kchan45/APPJ_Control/Software/Post-2020/Documentation/APPJ_Startup-Shudown_Procedure.docx

APPJ Startup/Shutdown Procedure

Mesbah Lab 2021

Last Updated: February 14, 2021

WARNING: The APPJ setup involves high voltage equipment! Use caution during operation, and DO NOT touch/reach into any part of the setup within the PVC cage!!

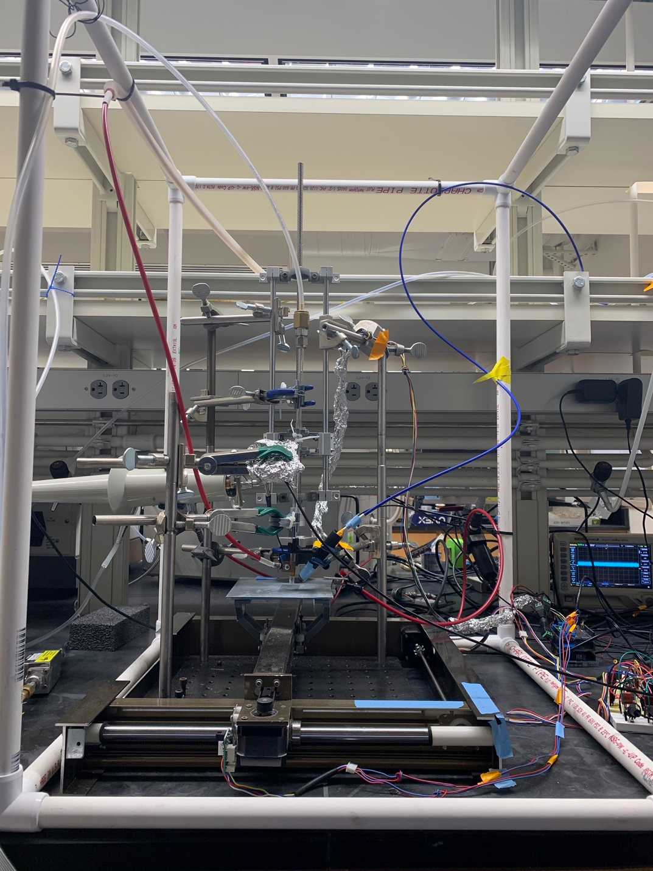
[picture p2: figure]

STARTUP:

1. Open Gas Flow (see Figure 1 for Helium tank setup):
  a. Ensure regulator (large red knob in center) is decreased fully.
  b. Open tank valve on the top of the He gas tank. The gauge on the right should indicate some pressure.
  c. Increase the regulator (turn clockwise) until the left gauge shows an appropriate amount of pressure (enough to get up to 3-5 slm).
  d. Open the line valve on the left (turn parallel to gas line)

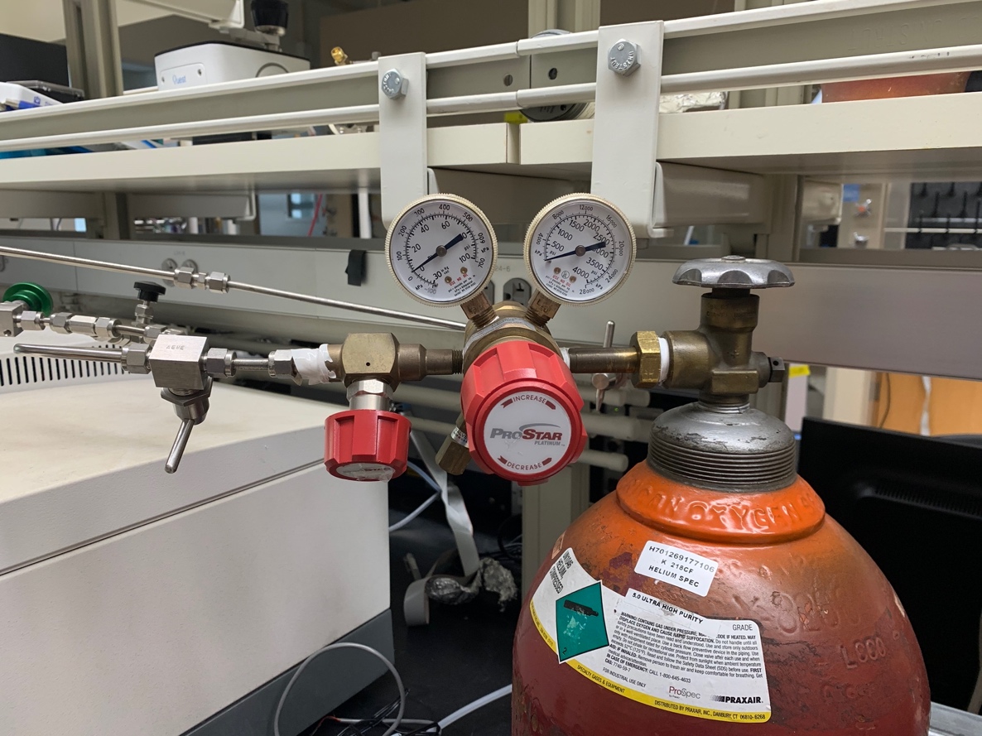
[picture p3: figure]

Line Valve

Regulator

Tank Valve

Figure 1: Helium Tank Setup

2. Turn on Amplifier for Frequency Generator (See Figure 2 for Amplifier startup):
  a. Flip the power switch to turn on power.
  b. Pull gray knob to unlock high voltage lock.
  c. Push white button to turn on high voltage. HV ON indicator light should light up green.

CAUTION: Once this is powered on, do NOT touch anything in the setup!!! Risk of high voltage delivered to body!

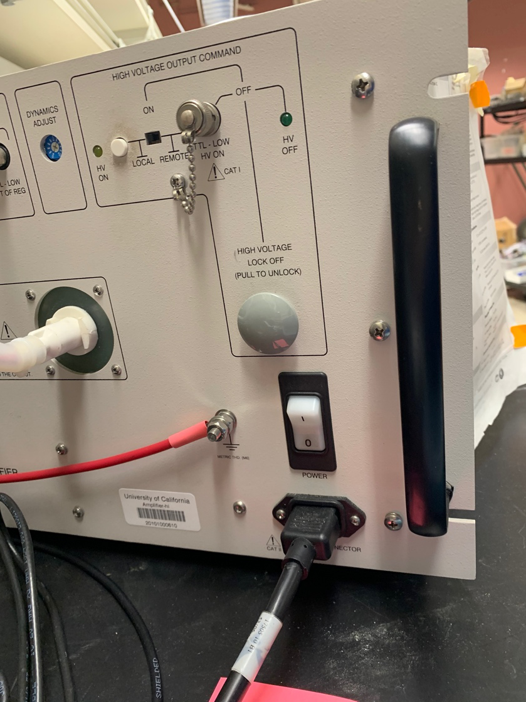
[picture p4: figure]

Figure 2: Amplifier Power Switches

Power Switch

High Voltage Lock

HV Local ON Button

3. Connect Computer to setup:
  a. Locate the USB Hub.
  b. Connect to computer.
4. Startup APPJ by EITHER:
  a. Running Python script: APPJstartup.py provided in APPJ-MacOS-Communication (ensure required dependencies/libraries for Python are installed with pip)
  b. Connecting to the Arduino directly using the following commands in the Terminal:
    i. This line starts/connects the Arduino to the computer and reads the status of the connection: $ stty -f /dev/cu.usbmodem1434401 raw 38400 -hupcl & cat /dev/cu.usbmodem1434401 Ensure the `usbmodem1434401` device number is consistent with what is read by your computer. If you have the Arduino app installed on your computer, this can be checked by going to Tools > Port, and looking at the Arduino device number.
    ii. Then, the following commands can be used to ignite the plasma:
      1. This command sets the duty to 100: $echo "p,100" > /dev/cu.usbmodem1434401
      2. This command sets the power to 2: $echo "w,2" > /dev/cu.usbmodem1434401
      3. This command sets the flow rate to 1.5: $echo "q,1.5" > /dev/cu.usbmodem1434401
    iii. Once started, the same commands can be used to adjust those parameters (duty, power, flow rate). Just change the numerical value in the quotes.

SHUTDOWN:

1. Push the reset button on the Arduino to reset all parameters.
2. Turn off Amplifier (see Figure 2):
  a. Flip the power switch to the off position.
  b. Push the gray knob to lock.
3. Turn off Gas (see Figure 1):
  a. Close tank valve on the top of the tank.
  b. Go to setup. On the manual flow controller (see Figure 3), flip the switch to ‘Purge’ to purge the remaining gas in setup.
  c. Decrease the regulator fully (turn counterclockwise).
  d. Close line valve (turn perpendicular to gas line).

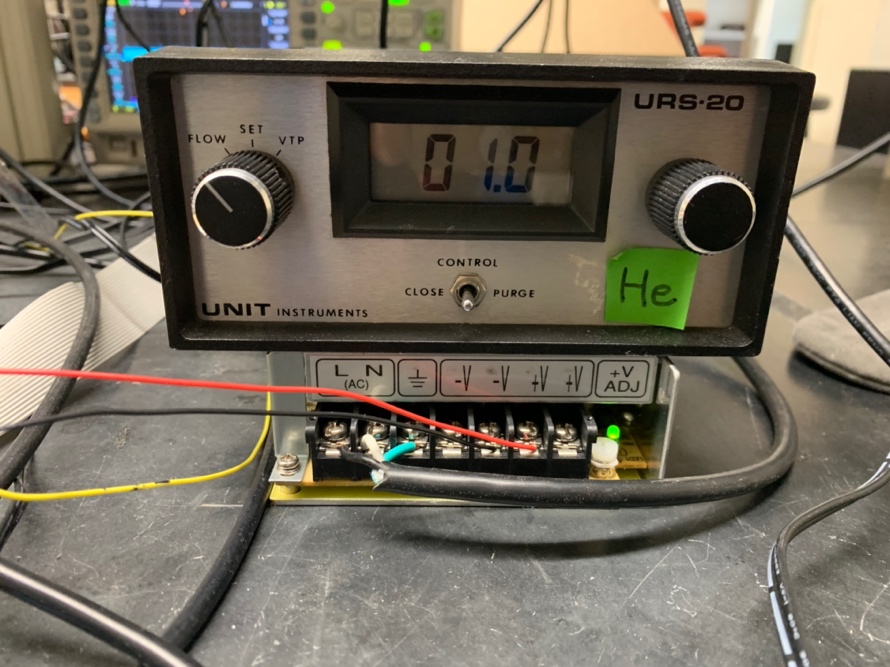
[picture p5: figure]

Figure 3: Manual Flow Controller
