kchan45/APPJ_Control/Software/Post-2020/Firmware/FLiR-lepton/Connections/Connections.png

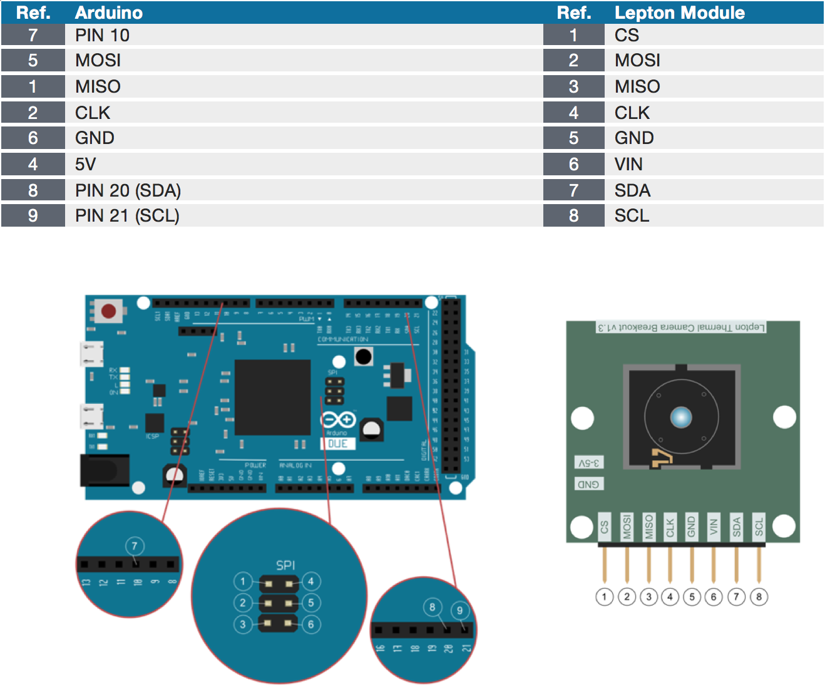
Software/Post-2020/Firmware/FLiR-lepton/Connections/Connections.png
