kchan45/APPJ_Control/Software/Post-2020/Firmware/FLiR-lepton/Connections/Image 2.png

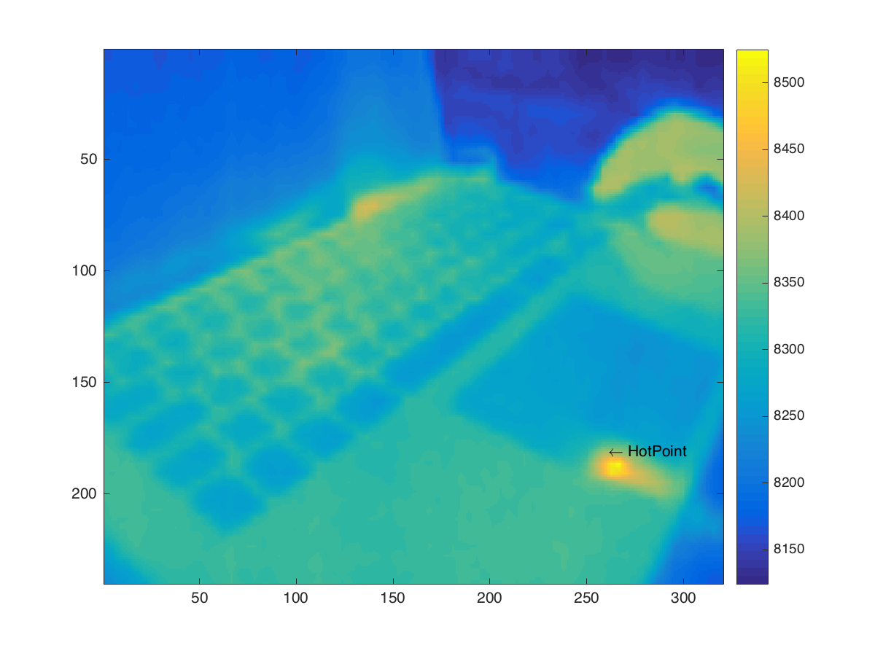
Software/Post-2020/Firmware/FLiR-lepton/Connections/Image 2.png
