kchan45/APPJ_Control/Img/APPJ Setup Pictures/Image_1 2021-03-11_18-36-17.jpeg

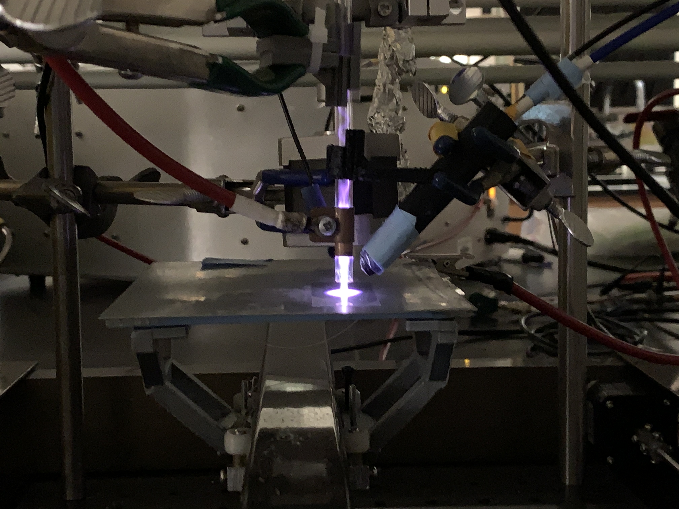
Img/APPJ Setup Pictures/Image_1 2021-03-11_18-36-17.jpeg
