kchan45/APPJ_Control/Img/APPJ Setup Pictures/IMG_1522.jpg

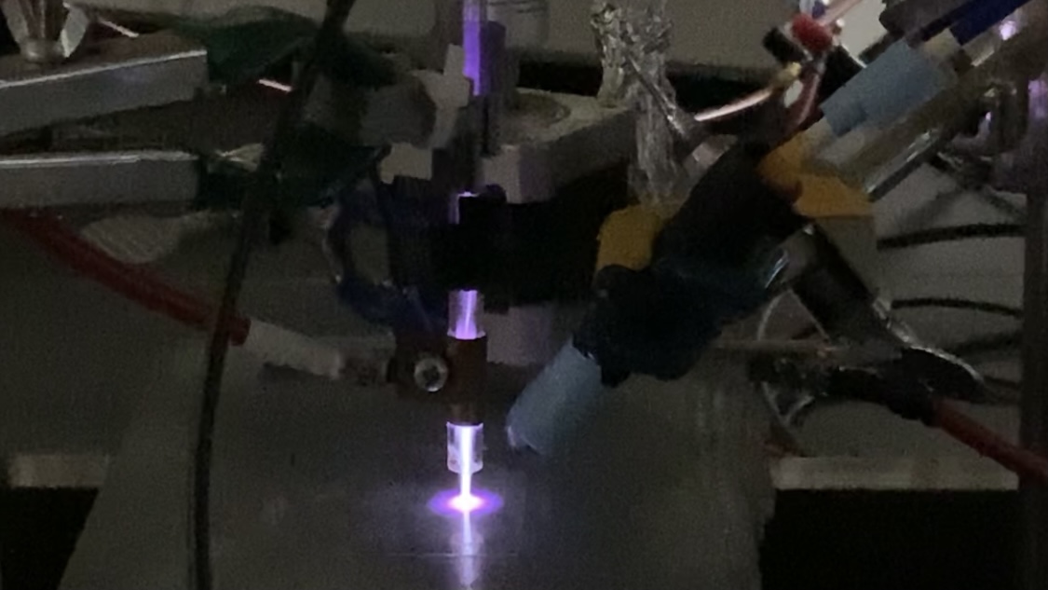
Img/APPJ Setup Pictures/IMG_1522.jpg
