kchan45/APPJ_Control/Img/APPJ Setup Pictures/IMG_1523 2.jpg

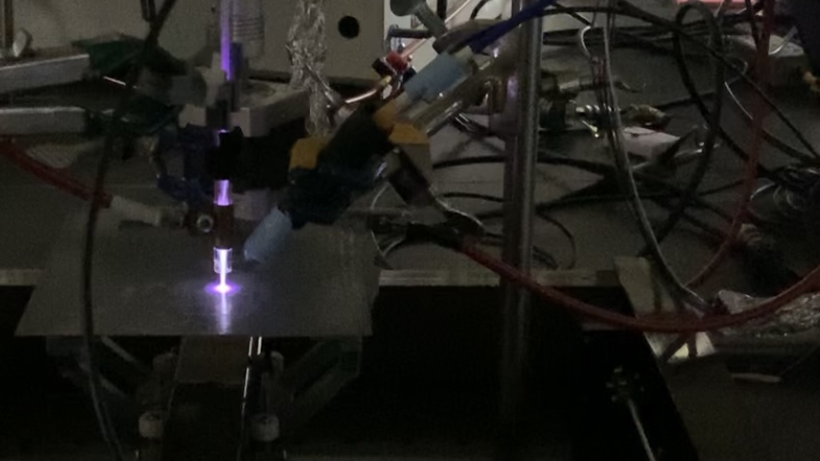
Img/APPJ Setup Pictures/IMG_1523 2.jpg
