kchan45/APPJ_Control/Miscellaneous/Post 2020/Circuits/Schematics/2021-04-16-APPJ-Schematic-Diagram.pdf

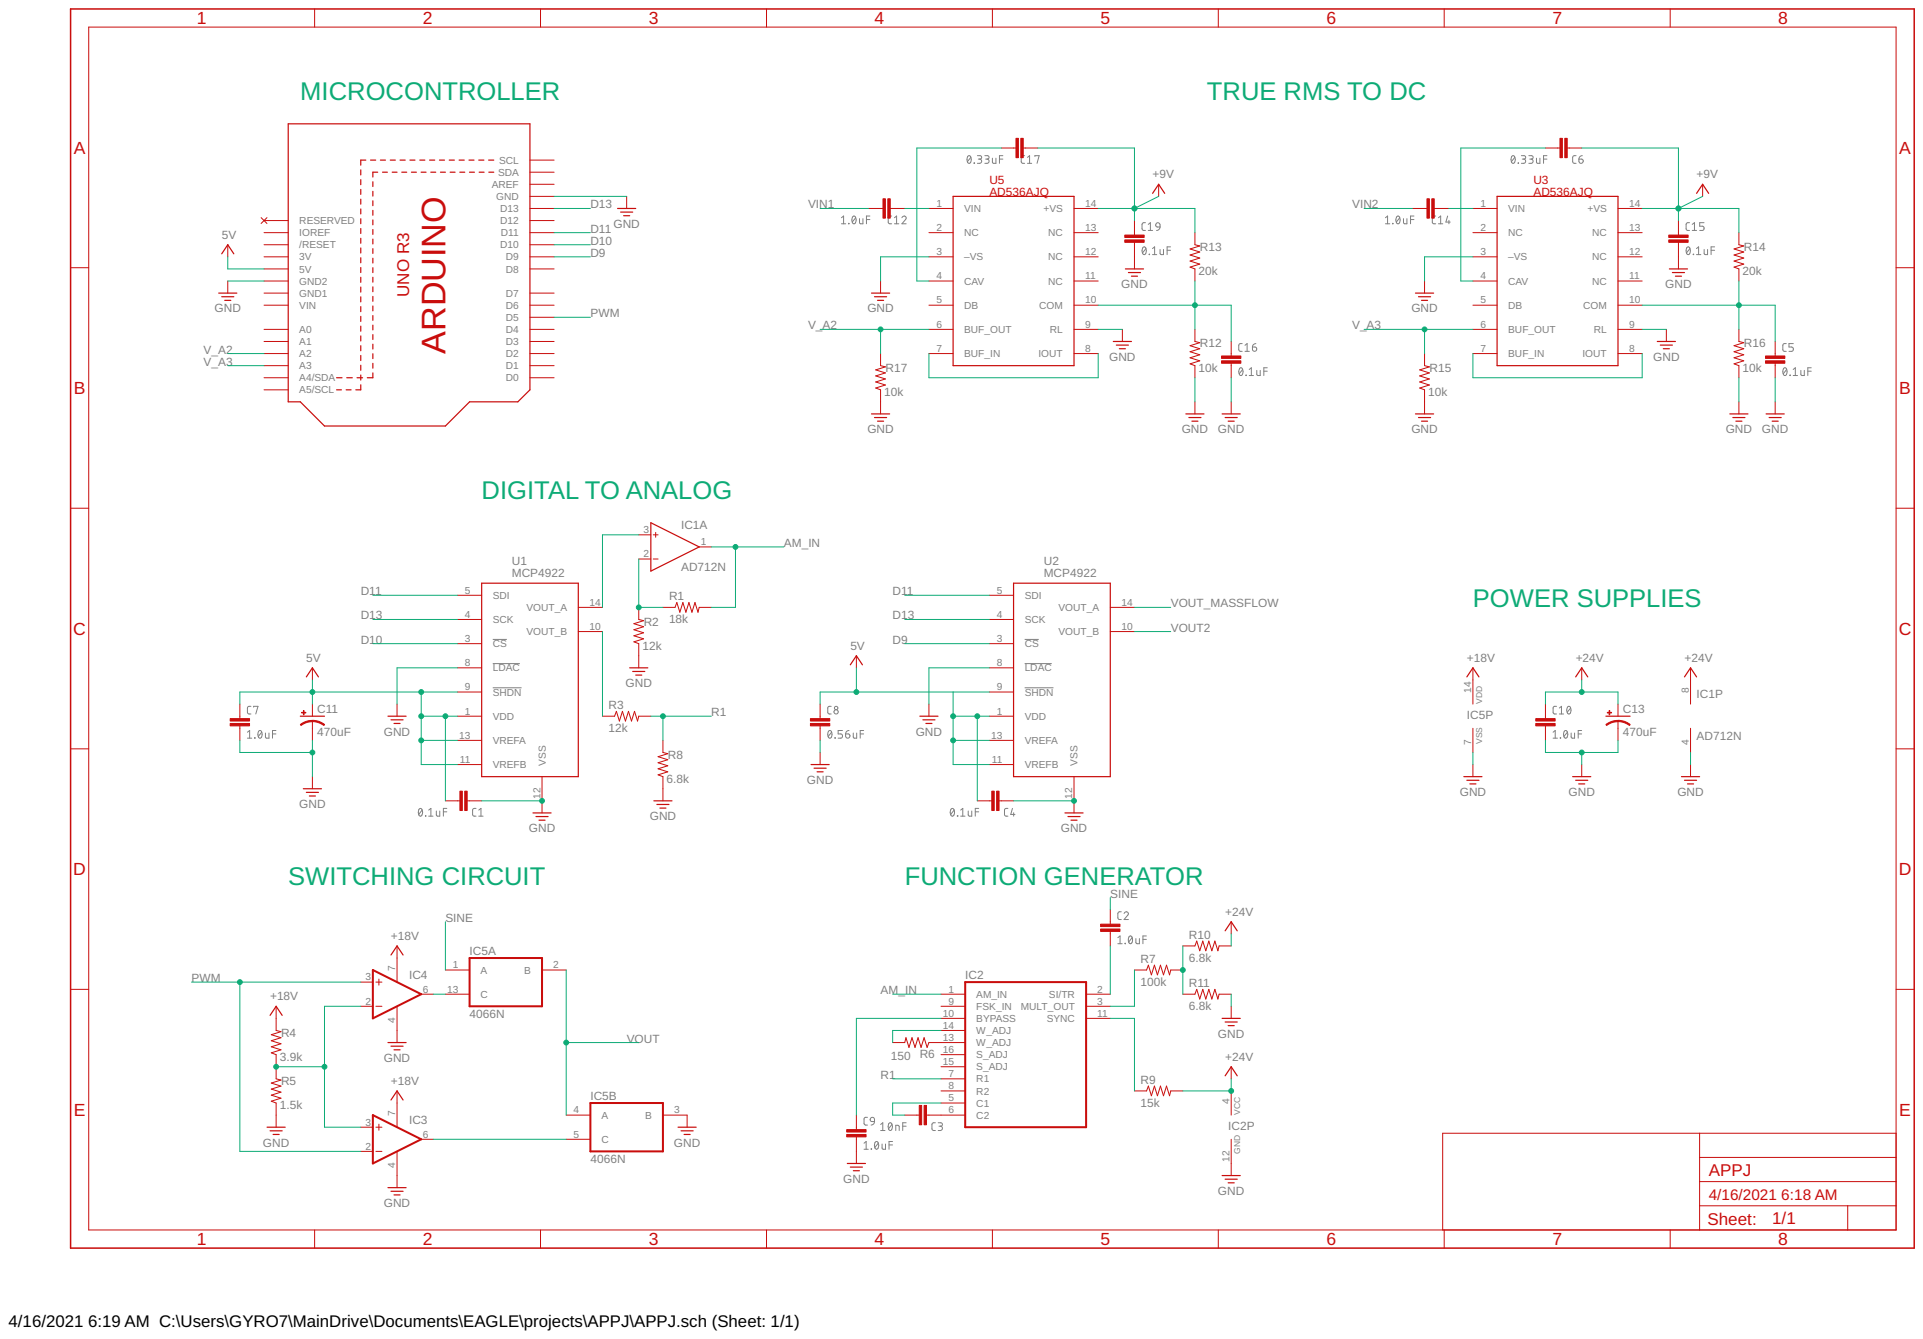
[picture p24: page 1]

4/16/2021 6:19 AM C:\Users\GYRO7\MainDrive\Documents\EAGLE\projects\APPJ\APPJ.sch (Sheet: 1/1)
