kchan45/APPJ_Control/Miscellaneous/Post 2020/Circuits/Pictures/overview_marked_ICs.pdf

000000

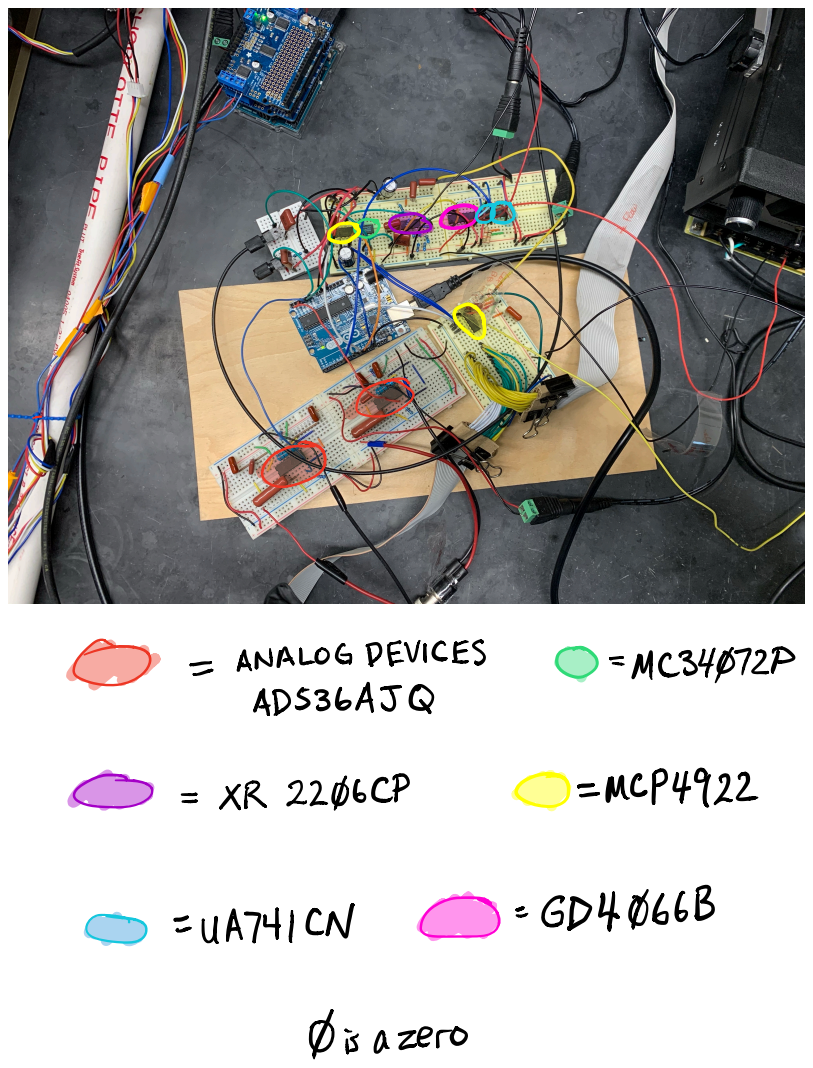
[picture p25: page 1]
ANALOGDEVICES; AD536AJQ; G MCP4922; UA74lCN; is a zero
