kchan45/APPJ_Control/Miscellaneous/Post 2020/nosync/thermograph_rd.py

#!/usr/bin/env python

"""
Thermography Interface

This script grabs data from the FLIR Lepton thermal camera and saves to a file

**modified to print out the timestamp, and maximal temperatures from two hardocded windows...
"""

import os
import datetime
import time
import numpy as np
import cv2
import argparse
from pylepton import Lepton

parser = argparse.ArgumentParser(description="collect and log data from the FLIR Lepton thermal camera")
parser.add_argument("--dir", type=str, default="data",
                        help="relative path to save the data")
parser.add_argument("--loop", help="repeatedly save data",
                        action="store_true")
opts = parser.parse_args()

SAVEDIR = os.path.join(os.getcwd(),opts.dir,"thermography") # path to the directory to save files
if not os.path.exists(SAVEDIR):
  print("Creating directory: {}".format(SAVEDIR))
  os.makedirs(SAVEDIR)

def save_data(data,fname):
#  print("saving {}.csv".format(os.path.join(SAVEDIR,fname)))
# np.savetxt(os.path.join(SAVEDIR,"{}.csv".format(fname)),data,delimiter=',',fmt='%.4e')
  data_surf=data[7:50]
  data_tube=data[1:6]
  Ts=np.true_divide(np.amax(data_surf),100)-273
  Tt=np.true_divide(np.amax(data_tube),100)-273
 # print(fname,r)
  print(fname,",",Ts, ",",Tt)


if __name__ == "__main__":
  run = True
  while run:
    with Lepton("/dev/spidev0.1") as l:
      data,_ = l.capture()
    for line in data:
      l = len(line)
      if (l != 80):
        print("error: should be 80 columns, but we got {}".format(l))
    curtime = datetime.datetime.now().strftime("%Y-%m-%d_%H%M%S.%f")
    fname = "{}".format(curtime)
	
    #save_data(data,fname)
	#print_data(data)
    time.sleep(0.1)
    run = opts.loop
