kchan45/APPJ_Control/Software/Post-2020/Firmware/FLiR-lepton/find_min.ino

void find_min(void)
{
  for (int j = 0; j < image_y; j++){
    for (int i = 0; i < image_x; i++){

      if (image[i][j] < minval){
        minval = image[i][j]; 
      }
    }
  }
  Serial.println(minval);
}
