kchan45/APPJ_Control/Software/Post-2020/Firmware/FLiR-lepton/lepton_command.ino

void lep_command(unsigned int moduleID, unsigned int commandID, unsigned int command){
  byte error;
  Wire.beginTransmission(ADDRESS);

  // Command Register is a 16-bit register located at Register Address 0x0004
  Wire.write(0x00);
  Wire.write(0x04);

  //OEM module ID
  if (moduleID == 0x08) {
    Wire.write(0x48);
  }
  else{
    Wire.write(moduleID & 0x0f);
  }
  
  Wire.write( ((commandID << 2 ) & 0xfc) | (command & 0x3));

  error = Wire.endTransmission();    // stop transmitting
  if (error != 0){
    Serial.print("error=");
    Serial.println(error);
  }
}
